vitaminHurricane/Balance_car/schematic/BOM_Balance_car_Schematic.xlsx

No. | Quantity | Comment | Designator | Footprint | Value | Manufacturer Part | Manufacturer | Supplier Part | Supplier
1 | 4 | 10uF | C1,C2,C3,C4 | C0805 | 10uF
2 | 2 | XH2.54-6P motor | CN1,CN2 | CONN-TH_XH2.54-6P |  | XH2.54-6P motor |  | C9900008614 | LCSC
3 | 1 | 2.54-1*4P OLED | H1 | HDR-TH_4P-P2.54-V-F |  | 2.54-1*4P OLED | BOOMELE(博穆精密) | C2718488 | LCSC
4 | 4 | HDR-F_2.54_1x2P | H2,H3,H4,H5 | HDR-TH_2P-P2.54-V-F |  |  |  | C49661
5 | 1 | STM32_L | P1 | HDR-TH_20P-P2.54-V-F |  | STM32_L | BOOMELE(博穆精密) | C50984 | LCSC
6 | 1 | STM32_R | P2 | HDR-TH_20P-P2.54-V-F |  | STM32_R | BOOMELE(博穆精密) | C50984 | LCSC
7 | 2 | 2.54-1*8P drive | P3,P4 | HDR-TH_8P-P2.54-V-F-1 |  | 2.54-1*8P drive | BOOMELE(博穆精密) | C27438 | LCSC
8 | 1 | 2.54-1*8P MPU6050 | P5 | HDR-TH_8P-P2.54-V-F-1 |  | 2.54-1*8P MPU6050 | BOOMELE(博穆精密) | C27438 | LCSC
9 | 1 | KF301-2P接线端子 | P8 | CONN-TH_XY301V-A-5.0-2P |  | KF301-2P接线端子 |  | C9900016950 | LCSC
10 | 4 | 轻触按键3*4*H | SW1,SW2,SW3,SW4 | SW-SMD_L4.0-W2.9-LS5.0 |  | 轻触按键3*4*H |  | C9900017573 | LCSC
11 | 1 | SS-3235S-L3 | SW5 | SW-SMD_SS-3235S-L3.00 |  | SS-3235S-L3 | XKB Connectivity(中国星坤) | C381098 | LCSC
