vitaminHurricane/Balance_car/schematic/SCH_Schematic1_2025-10-25.pdf

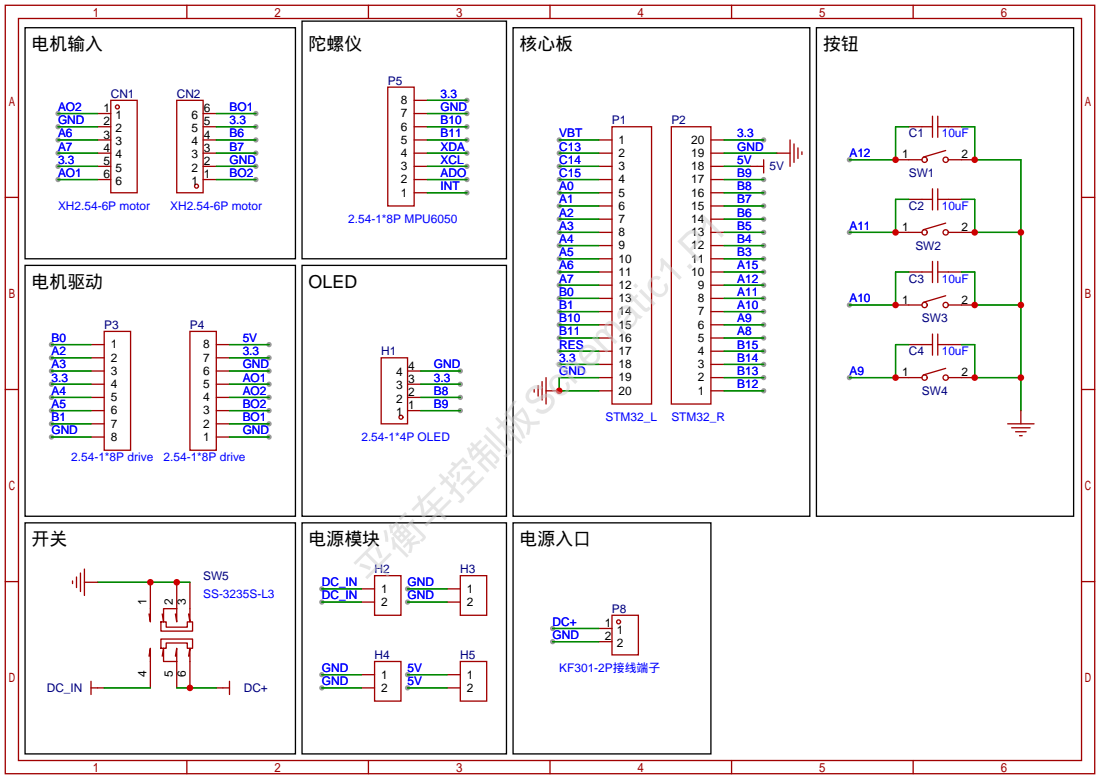
[picture p3: page 1]
