vitaminHurricane/Balance_car/Core/Src/main.c

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
/* Includes ------------------------------------------------------------------*/
#include "main.h"
#include "tim.h"
#include "gpio.h"

/* USER CODE BEGIN Includes */
#include <stdbool.h>
#include "motor.h"
#include "key.h"
#include "menu.h"
#include "encoder.h"
#include "oled.h"
#include "mpu6050.h"
#include "MyIIC.h"
#include "OLED.h"
#include "PID.h"
/* USER CODE END Includes */


void SystemClock_Config(void);
/* USER CODE BEGIN 0 */
bool start_flag = false;
bool debug_flag = false;

int16_t L_speed = 0;
int16_t R_speed = 0;

uint8_t cur_LA, cur_LB, pre_LA, pre_LB;
uint8_t cur_RA, cur_RB, pre_RA, pre_RB;

int16_t L_loc = 0, R_loc = 0;

float out_l = 0, out_r = 0;
float target_l = 0, target_r = 0;
float angle = 0;

uint8_t level = 1;

uint8_t num = 1;

infor MPU6050;
/* USER CODE END 0 */

/**
  * @brief  The application entry point.
  * @retval int
  */
int main(void)
{

  /* MCU Configuration--------------------------------------------------------*/

  /* Reset of all peripherals, Initializes the Flash interface and the Systick. */
  HAL_Init();

  /* Configure the system clock */
  SystemClock_Config();

  /* USER CODE BEGIN SysInit */
  OLED_Init();
  MPU6050_Init();
  HAL_Delay(50);
  Menu_Init();
  HAL_Delay(500);
  /* USER CODE END SysInit */

  /* Initialize all configured peripherals */
  MX_GPIO_Init();
  MX_TIM3_Init();
  MX_TIM4_Init();
  /* USER CODE BEGIN 2 */
  HAL_TIM_Base_Start_IT(&htim4);
  HAL_TIM_Base_Start_IT(&htim3); 
  HAL_TIM_PWM_Start(&htim3, TIM_CHANNEL_3);
  HAL_TIM_PWM_Start(&htim3, TIM_CHANNEL_4);
  /* USER CODE END 2 */

  /* Infinite loop */
  /* USER CODE BEGIN WHILE */
  while (1)
  {

    /* USER CODE END WHILE */

    /* USER CODE BEGIN 3 */
    MPU6050_GetData(&MPU6050);
    MPU6050_AttitudeEstimation();
    if (start_flag) {
      if (pitch_a >= 70 || pitch_a <= -70) {
        start_flag = !start_flag;
        HAL_GPIO_TogglePin(GPIOC, GPIO_PIN_13);
      }
    } else {
      Motor_Stop();
    }

  }
  /* USER CODE END 3 */
}

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
/* USER CODE BEGIN 4 */
void HAL_TIM_PeriodElapsedCallback(TIM_HandleTypeDef *htim)
{
	if (htim->Instance == TIM4) {           //TIM4 to check button state
		static uint8_t cnt = 0;
    static bool first_in = true;
		cnt++;
    //MPU6050_AttitudeEstimation();
		if (cnt >= 5) {
      num = Key_ActionPan();             //判断按键状态
      if (start_flag) {
        if (first_in) {
          OLED_Clear();
          first_in = false;
        }
        Menu_Page2(num);
      } else {
        if (!first_in) {
          OLED_Clear();
          first_in = true;
        }
        Menu_Main(num);
      }
      cnt = 0;
		}
	} else if (htim->Instance == TIM3) {    //TIM3 to catch encoder speed
		if (start_flag) {                     //每1ms进一次定时器3
		  PID_Balance(angle);
		  Motor_SetSpeed(Lmotor, target_l);
		  Motor_SetSpeed(Rmotor, target_r);
		} else {
		  PID_Clear();
		}
	} 
}


/* USER CODE END 4 */
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
