vitaminHurricane/Balance_car/(commit log)

2025-10-25 添加README文件
2025-10-25 核心模块部分提交OK
2025-10-25 驱动程序
2025-10-25 cubemx文件
2025-10-25 Keil5文件
